openrobots-dev/R2P_GW_module/doc/SD-47589-001.pdf

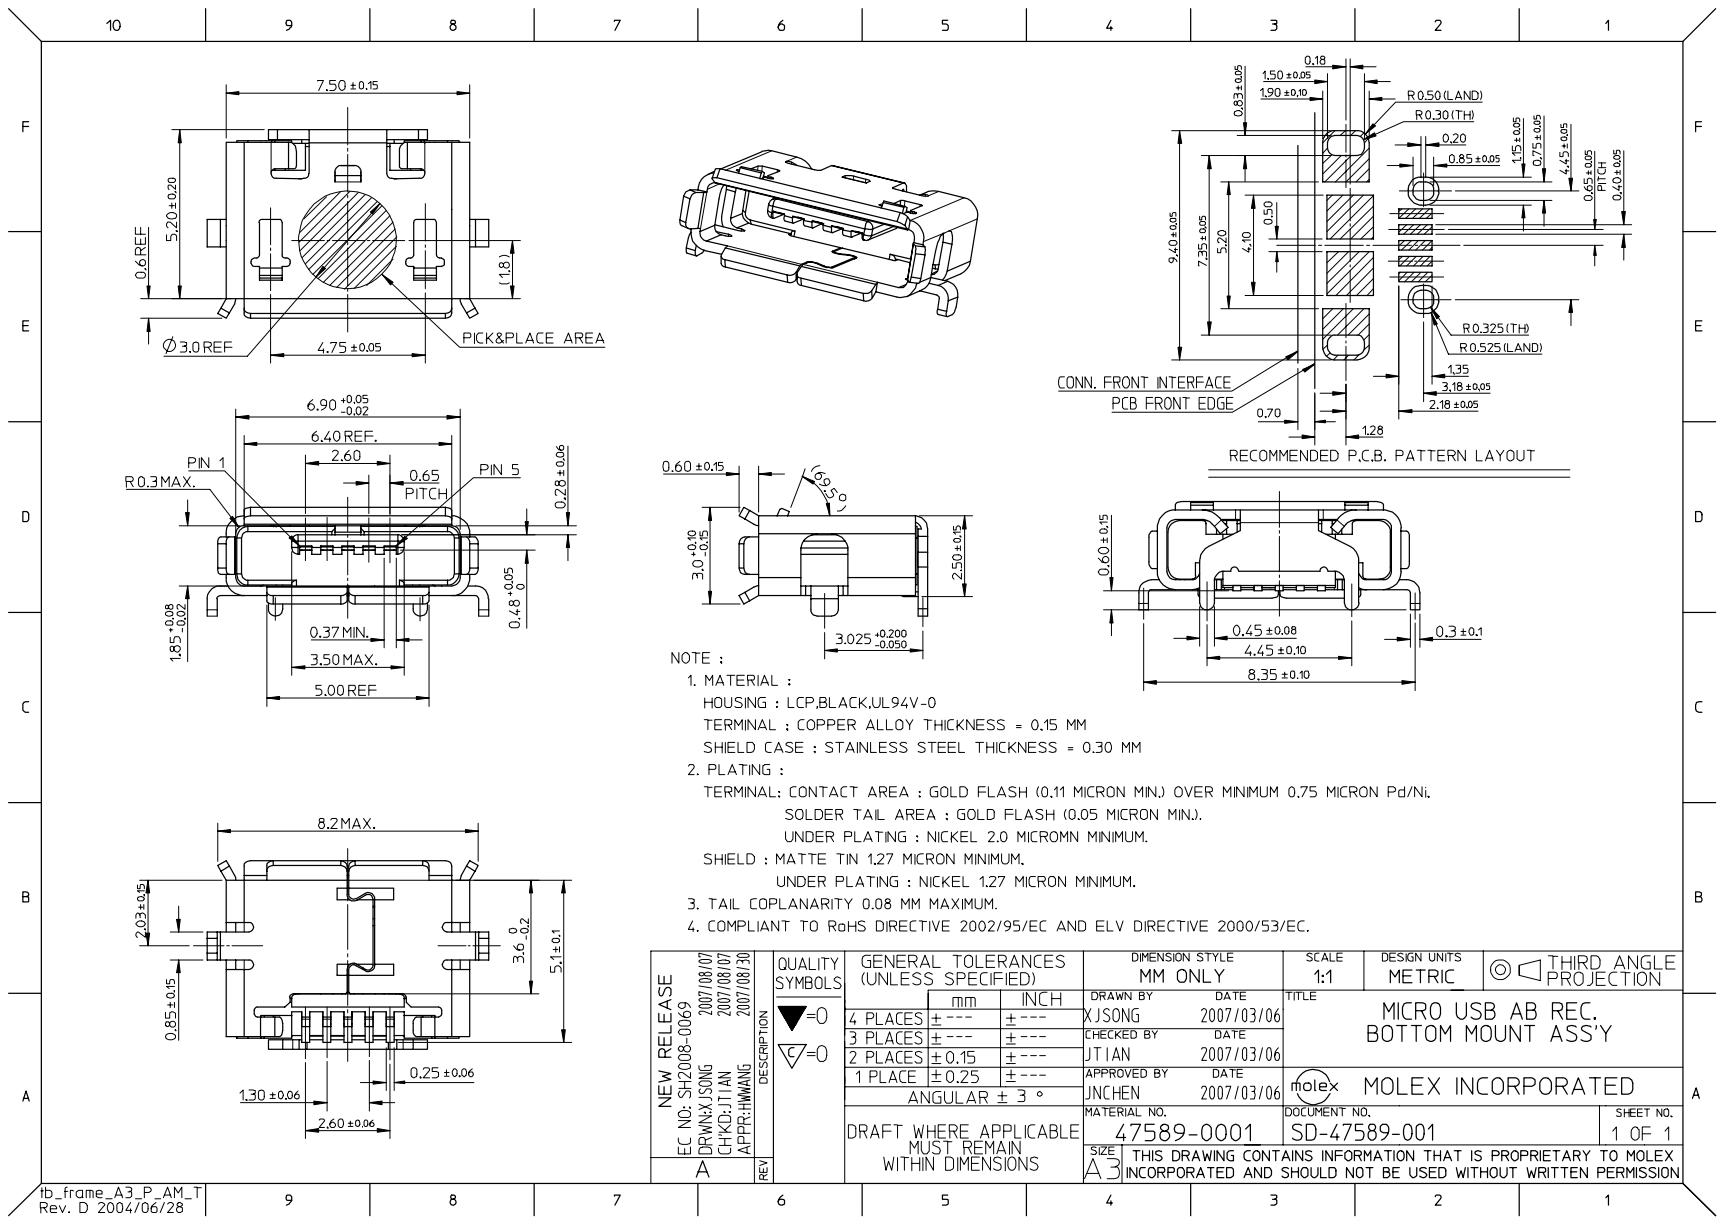
[picture p2: page 1]
