openrobots-dev/R2P_GW_module/doc/SI-60062-F.pdf

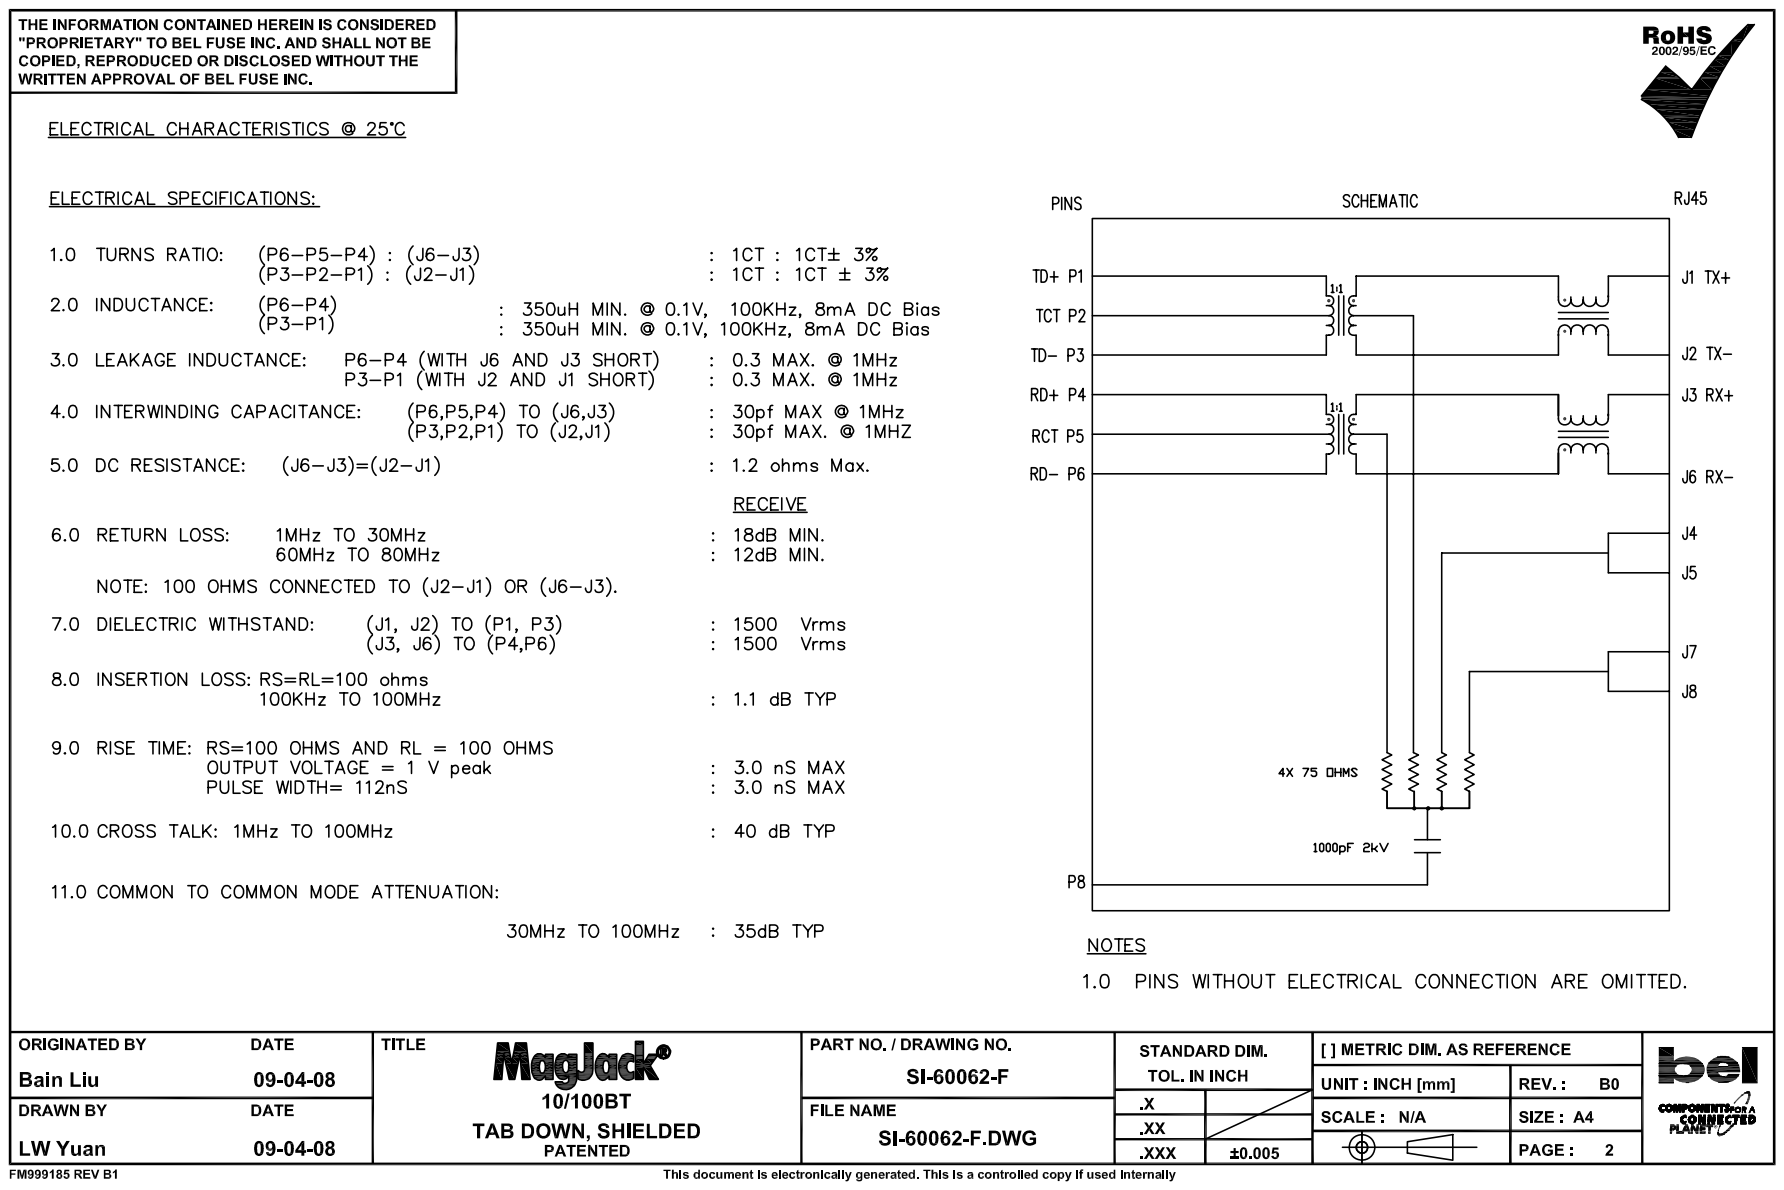
[picture p3: page 1]

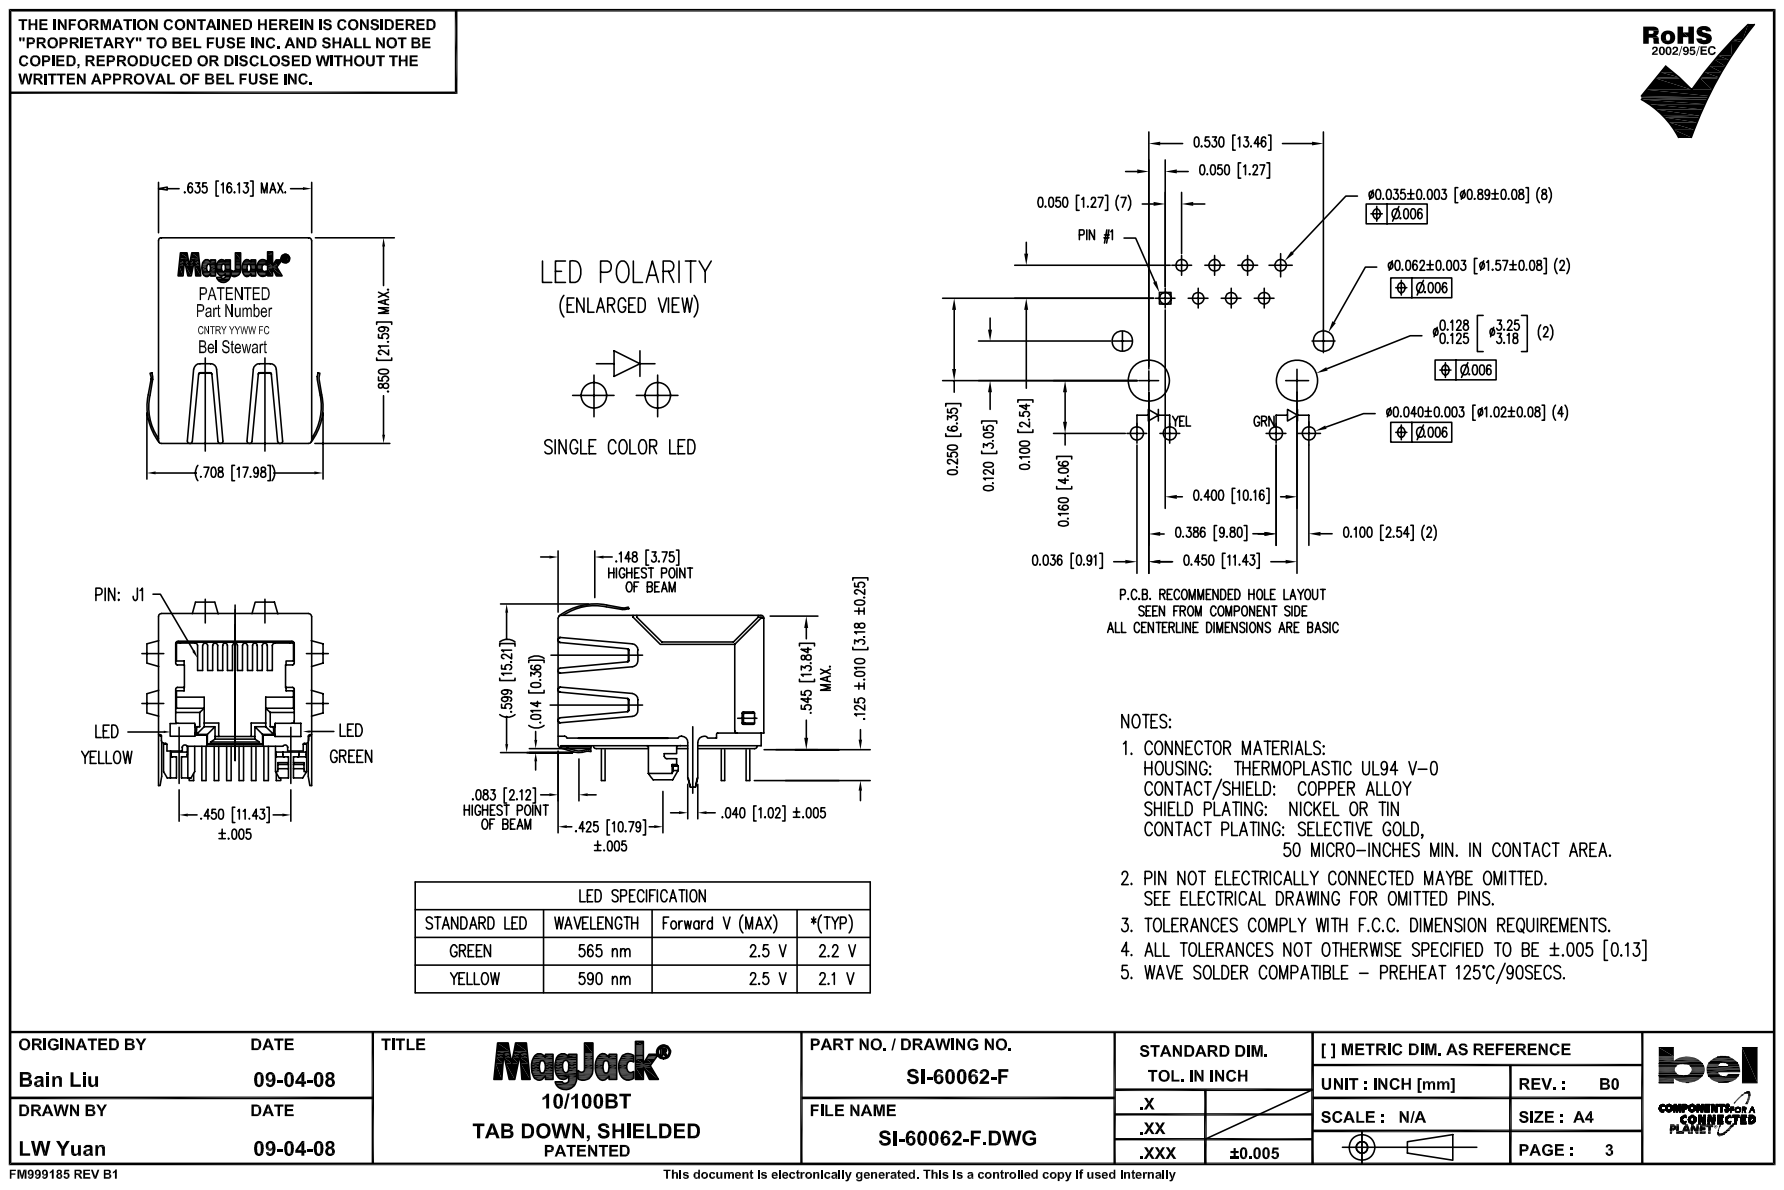
[picture p4: page 2]

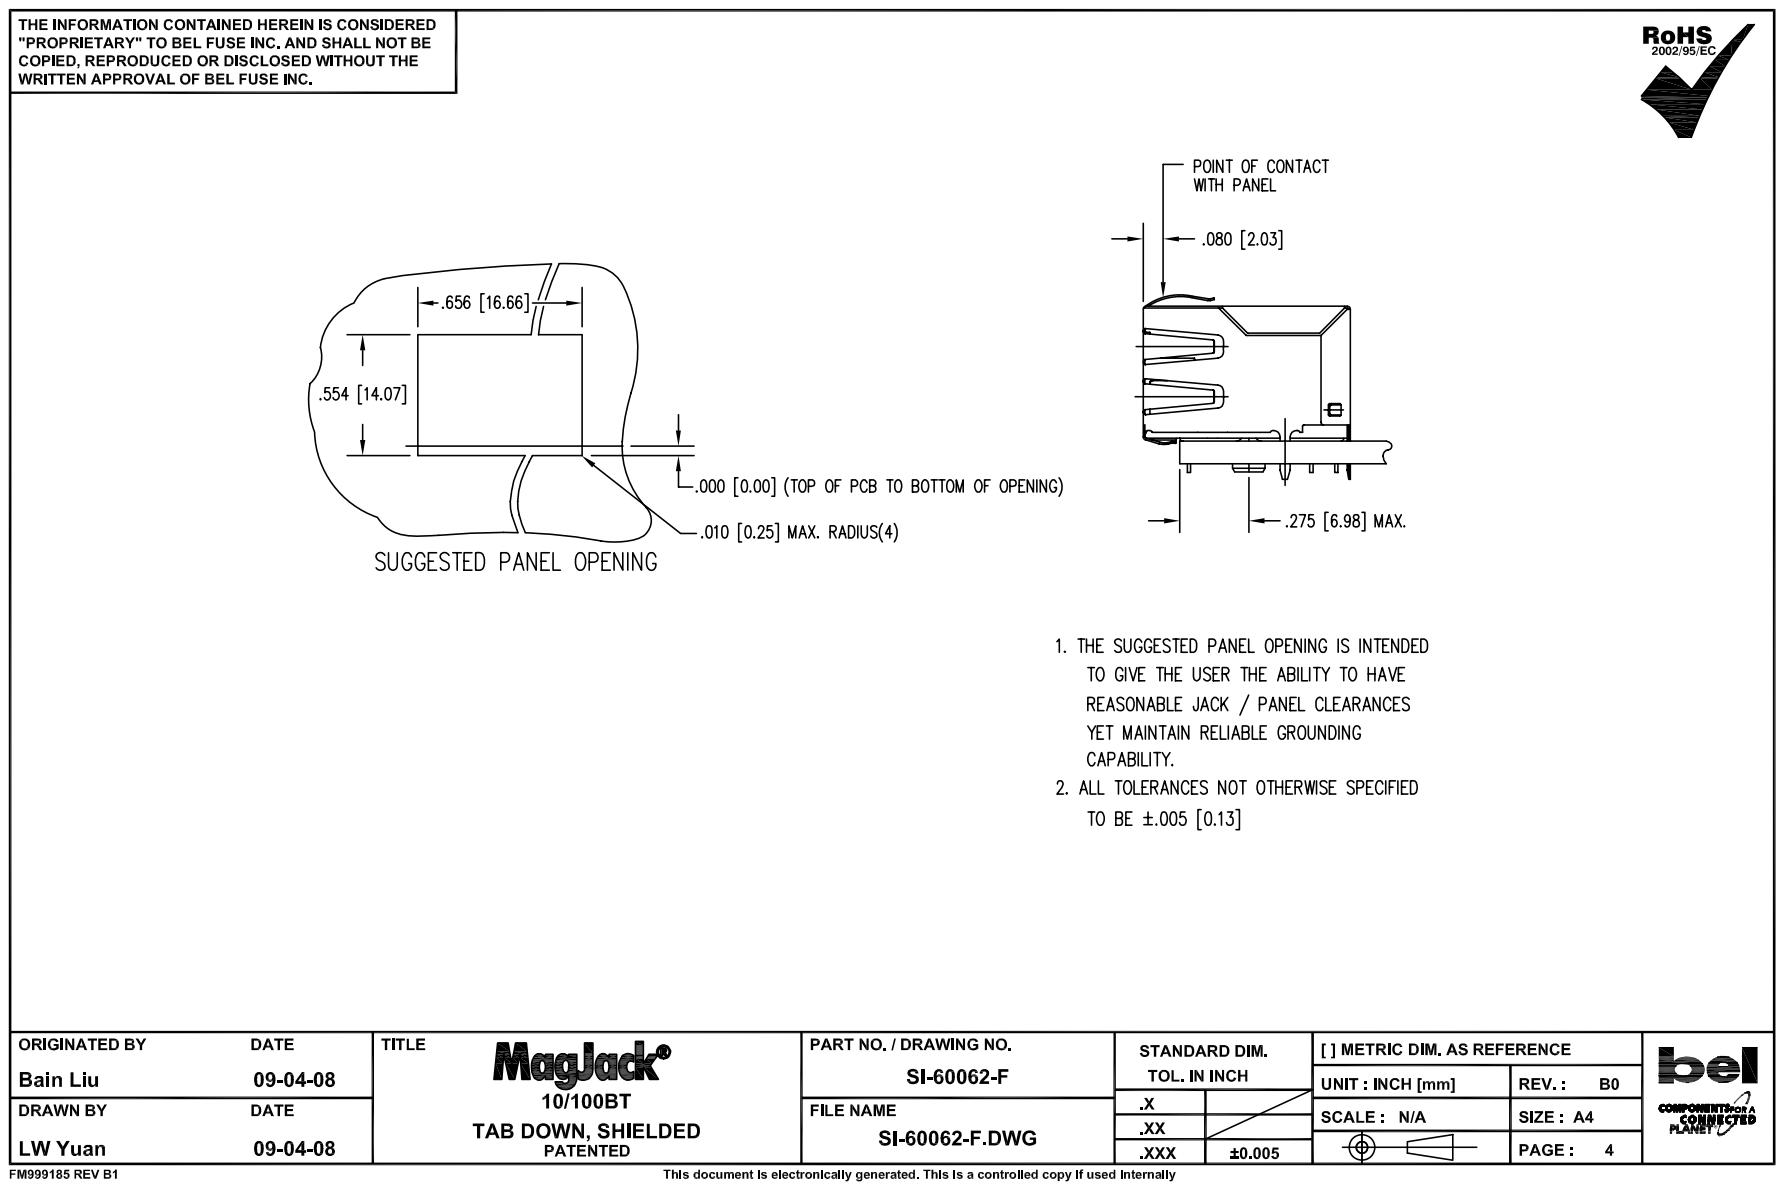
[picture p5: page 3]
