openrobots-dev/R2P_GW_module/hw/R2P_GW_module.brd

## EAGLE design hw/R2P_GW_module.brd (2013-06-18)

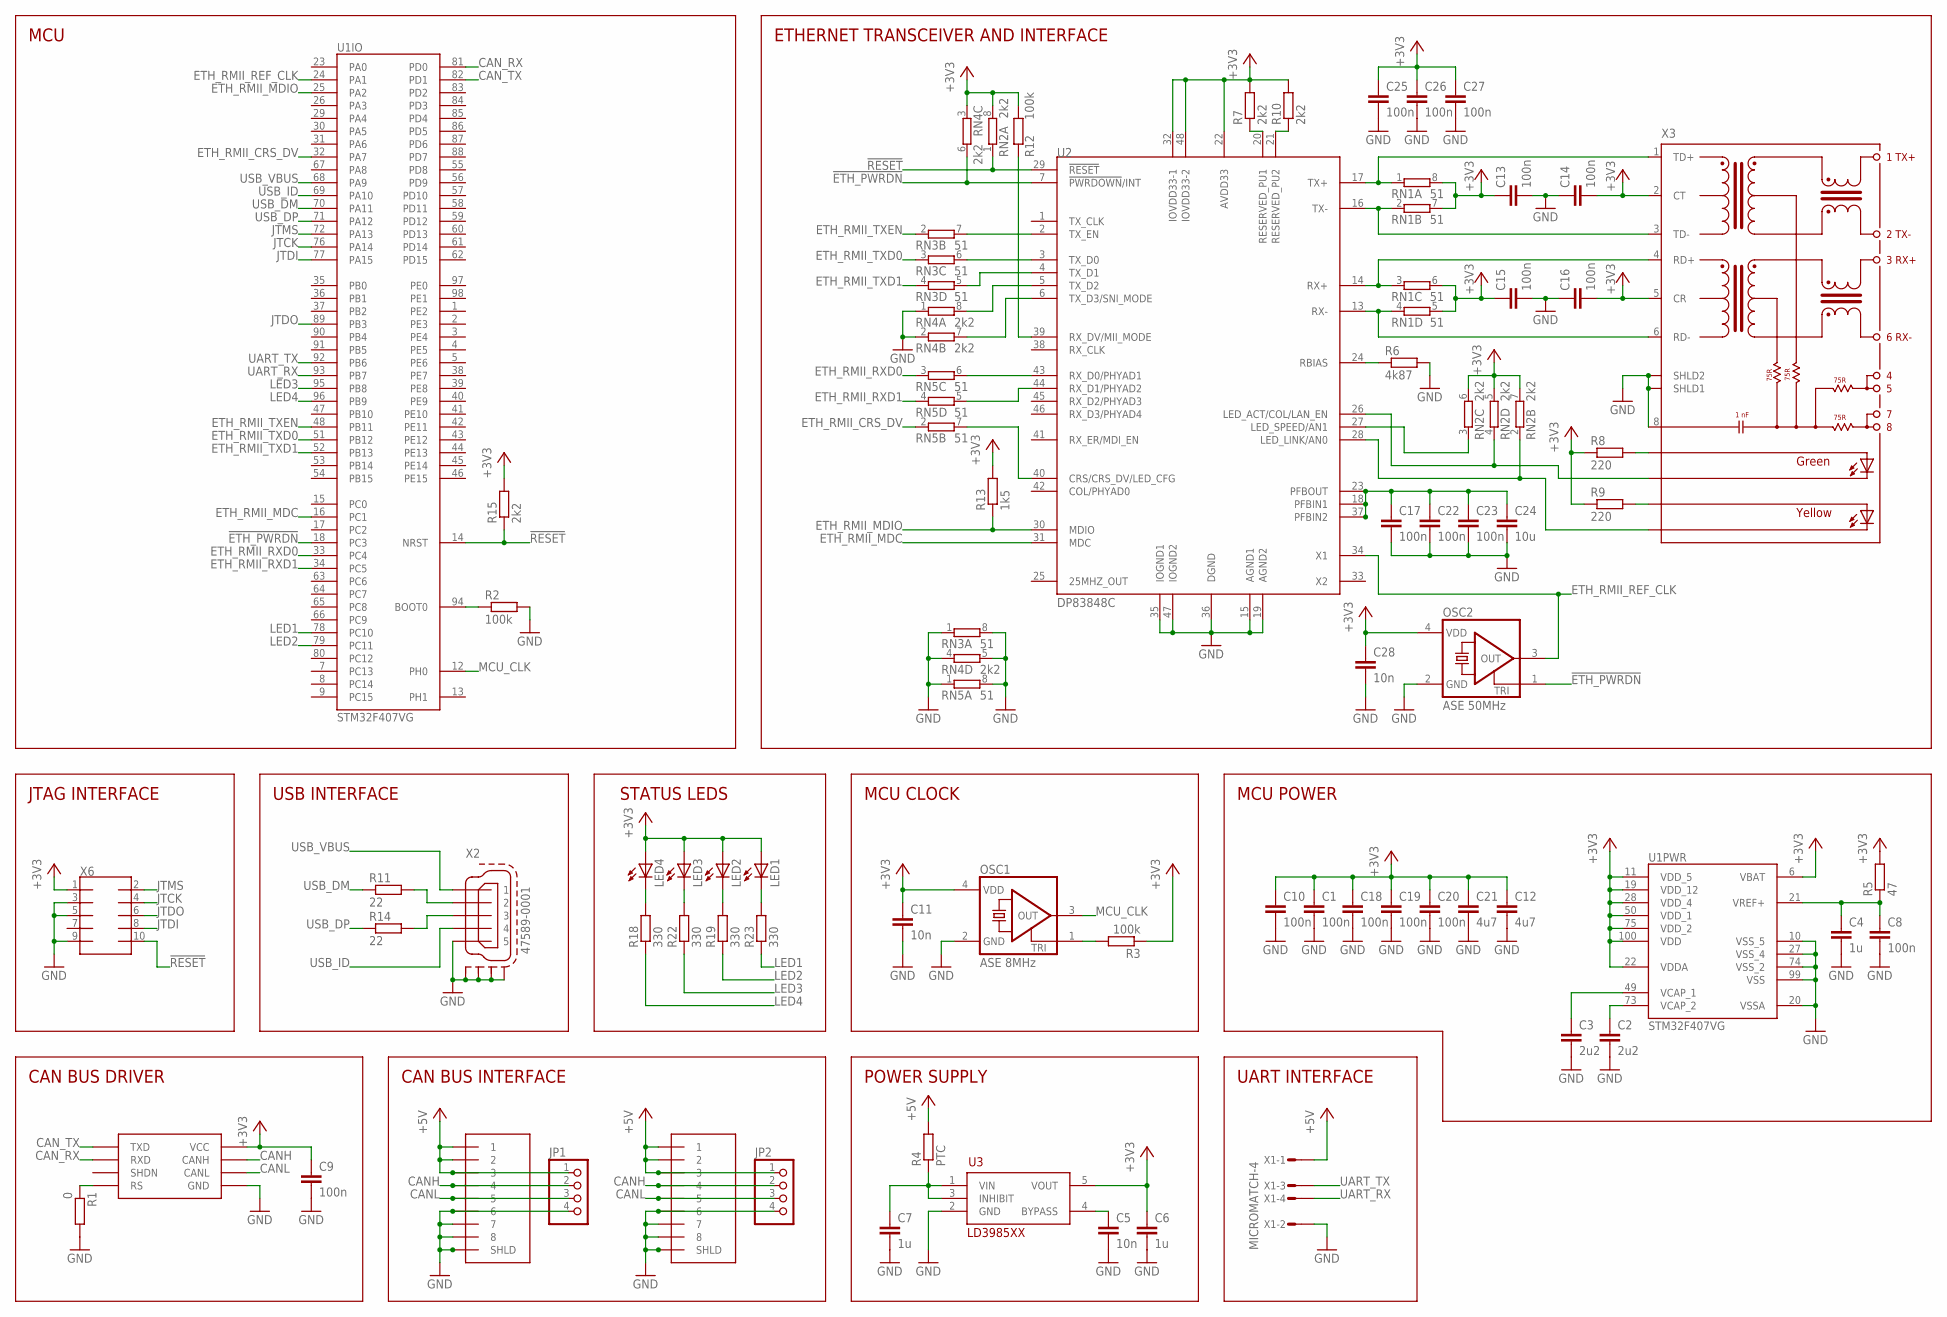
[picture p6: schematic R2P_GW_module.sch]

Parts:
C1, C8, C9, C10, C13, C14, C15, C16, C17, C18, C19, C20, C22, C23, C25, C26, C27: 100n; C0603
C2, C3: 2u2; C0805
C4, C6, C7: 1u; C0603
C5, C11, C28: 10n; C0603
C12, C21: 4u7; C0805
C24: 10u; C0805
JP1, JP2: PINHD-1X4; 1X04
LED1, LED2, LED3, LED4: LEDCHIPLED_0805; CHIPLED_0805
OSC1: ASE 8MHz; ASE
OSC2: ASE 50MHz; ASE
R1: 0; R0603
R2, R3, R12: 100k; R0603
R4: PTC; R0603
R5: 47; R0603
R6: 4k87; R0603
R7, R10, R15: 2k2; R0603
R8, R9: 220; R0603
R11, R14: 22; R0603
R13: 1k5; R0603
R18, R19, R22, R23: 330; R0603
RN1, RN3, RN5: 51; CAT16
RN2, RN4: 2k2; CAT16
U1: STM32F407VG; LQFP100
U2: DP83848C; LQFP48
U3: LD3985XX; SOT23-5L
U4: MAX3051; SOT23-8L
X1: MICROMATCH-4
X2: 47589-0001
X3: SI-60062-F
X4, X5: RJ45-43860; 0438600010
X6: FTSH-105

Connections:
!ETH_PWRDN: OSC2.1 (TRI), RN4.6 (2), U1.18 (PC3), U2.7 (!PWRDOWN!/INT)
!RESET: R15.1, RN2.1, U1.14 (NRST), U2.29 (!RESET), X6.10
+3V3: C1.1, C6.1, C9.1, C10.1, C11.1, C12.1, C13.1, C14.2, C15.1, C16.2, C18.1, C19.1, C20.1, C21.1, C25.1, C26.1, C27.1, C28.1, LED1.A, LED2.A, LED3.A, LED4.A, OSC1.4 (VDD), OSC2.4 (VDD), R3.1, R5.2, R7.2, R8.1, R9.1, R10.2, R12.2, R13.2, R15.2, RN1.5 (2), RN1.6 (2), RN1.7 (2), RN1.8 (2), RN2.5 (2), RN2.6 (2), RN2.7 (2), RN2.8 (2), RN4.3 (1), U1.6 (VBAT), U1.11 (VDD_5), U1.19 (VDD_12), U1.22 (VDDA), U1.28 (VDD_4), U1.50 (VDD_1), U1.75 (VDD_2), U1.100 (VDD), U2.22 (AVDD33), U2.32 (IOVDD33-1), U2.48 (IOVDD33-2), U3.5 (VOUT), U4.P$3 (VCC), X3.2 (CT), X3.5 (CR), X6.1
+5V: JP1.1, JP2.1, R4.2, X1.1, X4.P$1 (1), X4.P$2 (2), X4.P$3 (3), X5.P$1 (1), X5.P$2 (2), X5.P$3 (3)
CANH: JP1.2, JP2.2, U4.P$7 (CANH), X4.P$4 (4), X5.P$4 (4)
CANL: JP1.3, JP2.3, U4.P$6 (CANL), X4.P$5 (5), X5.P$5 (5)
CAN_RX: U1.81 (PD0), U4.P$4 (RXD)
CAN_TX: U1.82 (PD1), U4.P$1 (TXD)
ETH_RMII_CRS_DV: RN5.2 (1), U1.32 (PA7)
ETH_RMII_MDC: U1.16 (PC1), U2.31 (MDC)
ETH_RMII_MDIO: R13.1, U1.25 (PA2), U2.30 (MDIO)
ETH_RMII_REF_CLK: OSC2.3 (OUT), U1.24 (PA1), U2.34 (X1)
ETH_RMII_RXD0: RN5.3 (1), U1.33 (PC4)
ETH_RMII_RXD1: RN5.4 (1), U1.34 (PC5)
ETH_RMII_TXD0: RN3.3 (1), U1.51 (PB12)
ETH_RMII_TXD1: RN3.4 (1), U1.52 (PB13)
ETH_RMII_TXEN: RN3.2 (1), U1.48 (PB11)
GND: C1.2, C2.2, C3.2, C4.2, C5.2, C6.2, C7.2, C8.2, C9.2, C10.2, C11.2, C12.2, C13.2, C14.1, C15.2, C16.1, C17.2, C18.2, C19.2, C20.2, C21.2, C22.2, C23.2, C24.2, C25.2, C26.2, C27.2, C28.2, JP1.4, JP2.4, OSC1.2 (GND), OSC2.2 (GND), R1.2, R2.2, R6.2, RN3.1, RN3.8 (2), RN4.1, RN4.2 (1), RN4.4 (1), RN4.5 (2), RN5.1, RN5.8 (2), U1.10 (VSS_5), U1.20 (VSSA), U1.27 (VSS_4), U1.74 (VSS_2), U1.99 (VSS), U2.15 (AGND1), U2.19 (AGND2), U2.35 (IOGND1), U2.36 (DGND), U2.47 (IOGND2), U3.2 (GND), U4.P$2 (GND), X1.2, X2.5, X2.SHLD1, X2.SHLD2, X2.SHLD3, X2.SHLD4, X3.8, X3.SHLD1, X3.SHLD2, X4.P$6 (6), X4.P$7 (7), X4.P$8 (8), X4.P$9 (SHLD), X4.P$10, X5.P$6 (6), X5.P$7 (7), X5.P$8 (8), X5.P$9 (SHLD), X5.P$10, X6.3, X6.5, X6.9
JTCK: U1.76 (PA14), X6.4
JTDI: U1.77 (PA15), X6.8
JTDO: U1.89 (PB3), X6.6
JTMS: U1.72 (PA13), X6.2
LED1: R23.1, U1.78 (PC10)
LED2: R19.1, U1.79 (PC11)
LED3: R22.1, U1.95 (PB8)
LED4: R18.1, U1.96 (PB9)
MCU_CLK: OSC1.3 (OUT), U1.12 (PH0)
unnamed: C4.1, C8.1, R5.1, U1.21 (VREF+)
unnamed: R1.1, U4.P$8 (RS)
unnamed: OSC1.1 (TRI), R3.2
unnamed: C5.1, U3.4 (BYPASS)
unnamed: C7.1, R4.1, U3.1 (VIN), U3.3 (INHIBIT)
unnamed: R6.1, U2.24 (RBIAS)
unnamed: R11.2, X2.2
unnamed: RN1.1, U2.17 (TX+), X3.1 (TD+)
unnamed: RN1.2 (1), U2.16 (TX-), X3.3 (TD-)
unnamed: RN1.3 (1), U2.14 (RX+), X3.4 (RD+)
unnamed: RN1.4 (1), U2.13 (RX-), X3.6 (RD-)
unnamed: R9.2, X3.YA
unnamed: C17.1, C22.1, C23.1, C24.1, U2.18 (PFBIN1), U2.23 (PFBOUT), U2.37 (PFBIN2)
unnamed: LED4.C, R18.2
unnamed: R8.2, X3.GA
unnamed: LED2.C, R19.2
unnamed: RN2.3 (1), U2.27 (LED_SPEED/AN1)
unnamed: LED3.C, R22.2
unnamed: RN3.7 (2), U2.2 (TX_EN)
unnamed: LED1.C, R23.2
unnamed: RN2.2 (1), U2.28 (LED_LINK/AN0), X3.YK
unnamed: RN2.4 (1), U2.26 (LED_ACT/COL/LAN_EN), X3.GK
unnamed: RN3.6 (2), U2.3 (TX_D0)
unnamed: R2.1, U1.94 (BOOT0)
unnamed: R7.1, U2.20 (RESERVED_PU1)
unnamed: R10.1, U2.21 (RESERVED_PU2)
unnamed: RN3.5 (2), U2.4 (TX_D1)
unnamed: RN4.8 (2), U2.5 (TX_D2)
unnamed: RN4.7 (2), U2.6 (TX_D3/SNI_MODE)
unnamed: R14.2, X2.3
unnamed: RN5.6 (2), U2.43 (RX_D0/PHYAD1)
unnamed: R12.1, U2.39 (RX_DV/MII_MODE)
unnamed: RN5.5 (2), U2.44 (RX_D1/PHYAD2)
unnamed: RN5.7 (2), U2.40 (CRS/CRS_DV/LED_CFG)
UART_RX: U1.93 (PB7), X1.4
UART_TX: U1.92 (PB6), X1.3
USB_DM: R11.1, U1.70 (PA11)
USB_DP: R14.1, U1.71 (PA12)
USB_ID: U1.69 (PA10), X2.4
USB_VBUS: U1.68 (PA9), X2.1
VCAP_1: C3.1, U1.49 (VCAP_1)
VCAP_2: C2.1, U1.73 (VCAP_2)

Notes on the sheet:
MCU
POWER SUPPLY
STATUS LEDS
JTAG INTERFACE
CAN BUS INTERFACE
CAN BUS DRIVER
UART INTERFACE
ETHERNET TRANSCEIVER AND INTERFACE
MCU POWER
MCU CLOCK
USB INTERFACE

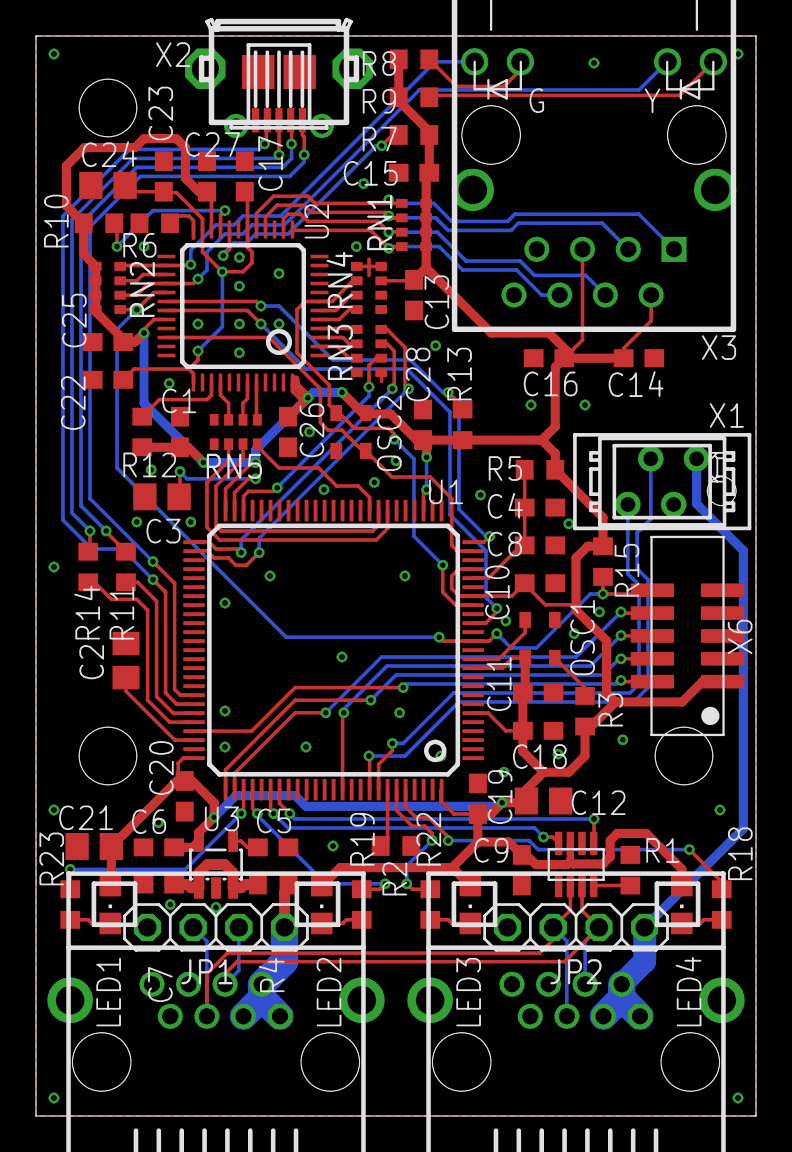
[picture p7: board R2P_GW_module.brd from above]

Board: 2 copper layers, 40.0 x 60.0 mm, 70 parts (0 on the bottom side), 69 nets.
