openrobots-dev/R2P_GW_module/board.h

/*
    ChibiOS/RT - Copyright (C) 2006,2007,2008,2009,2010,
                 2011,2012 Giovanni Di Sirio.

    This file is part of ChibiOS/RT.

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
    You should have received a copy of the GNU General Public License
    along with this program.  If not, see <http://www.gnu.org/licenses/>.
*/

#ifndef _BOARD_H_
#define _BOARD_H_

/*
 * Setup for R2P_GW board.
 */

/*
 * Board identifier.
 */
#define BOARD_R2P_GW
#define BOARD_NAME                  "R2P_GW"

/*
 * Ethernet PHY type.
 */
#define BOARD_PHY_ID                MII_DP83848I_ID
#define BOARD_PHY_RMII

/*
 * Board oscillators-related settings.
 */
#if !defined(STM32_LSECLK)
#define STM32_LSECLK                32768
#endif

#if !defined(STM32_HSECLK)
#define STM32_HSECLK                8000000
#endif


/*
 * Board voltages.
 * Required for performance limits calculation.
 */
#define STM32_VDD                   330

/*
 * MCU type as defined in the ST header file stm32f4xx.h.
 */
#define STM32F4XX

/*
 * IO pins assignments.
 */
#define GPIOA_PIN0                  0
#define GPIOA_ETH_RMII_REF_CLK      1
#define GPIOA_ETH_RMII_MDIO         2
#define GPIOA_PIN3                  3
#define GPIOA_PIN4                  4
#define GPIOA_PIN5                  5
#define GPIOA_PIN6                  6
#define GPIOA_ETH_RMII_CRS_DV       7
#define GPIOA_PIN8                  8
#define GPIOA_OTG_FS_VBUS           9
#define GPIOA_OTG_FS_ID             10
#define GPIOA_OTG_FS_DM             11
#define GPIOA_OTG_FS_DP             12
#define GPIOA_JTMS                  13
#define GPIOA_JTCK                  14
#define GPIOA_JTDI                  15

#define GPIOB_PIN0                  0
#define GPIOB_PIN1                  1
#define GPIOB_PIN2                  2
#define GPIOB_JTDO                  3
#define GPIOB_JTRST                 4
#define GPIOB_PIN5                  5
#define GPIOB_USART1_TX             6
#define GPIOB_USART1_RX             7
#define GPIOB_LED3                  8
#define GPIOB_LED4                  9
#define GPIOB_PIN10                 10
#define GPIOB_ETH_RMII_TX_EN        11
#define GPIOB_ETH_RMII_TXD0         12
#define GPIOB_ETH_RMII_TXD1         13
#define GPIOB_PIN14                 14
#define GPIOB_PIN15                 15

#define GPIOC_PIN0                  0
#define GPIOC_ETH_RMII_MDC          1
#define GPIOC_PIN2                  2
#define GPIOC_ETH_NOT_PWRDN         3
#define GPIOC_ETH_RMII_RXD0         4
#define GPIOC_ETH_RMII_RXD1         5
#define GPIOC_PIN6                  6
#define GPIOC_PIN7                  7
#define GPIOC_PIN8                  8
#define GPIOC_PIN9                  9
#define GPIOC_LED1                  10
#define GPIOC_LED2                  11
#define GPIOC_PIN12                 12
#define GPIOC_PIN13                 13
#define GPIOC_PIN14                 14
#define GPIOC_PIN15                 15

#define GPIOD_CAN1_RX               0
#define GPIOD_CAN1_TX               1
#define GPIOD_PIN2                  2
#define GPIOD_PIN3                  3
#define GPIOD_PIN4                  4
#define GPIOD_PIN5                  5
#define GPIOD_PIN6                  6
#define GPIOD_PIN7                  7
#define GPIOD_PIN8                  8
#define GPIOD_PIN9                  9
#define GPIOD_PIN10                 10
#define GPIOD_PIN11                 11
#define GPIOD_PIN12                 12
#define GPIOD_PIN13                 13
#define GPIOD_PIN14                 14
#define GPIOD_PIN15                 15

#define GPIOE_PIN0                  0
#define GPIOE_PIN1                  1
#define GPIOE_PIN2                  2
#define GPIOE_PIN3                  3
#define GPIOE_PIN4                  4
#define GPIOE_PIN5                  5
#define GPIOE_PIN6                  6
#define GPIOE_PIN7                  7
#define GPIOE_PIN8                  8
#define GPIOE_PIN9                  9
#define GPIOE_PIN10                 10
#define GPIOE_PIN11                 11
#define GPIOE_PIN12                 12
#define GPIOE_PIN13                 13
#define GPIOE_PIN14                 14
#define GPIOE_PIN15                 15

#define GPIOF_PIN0                  0
#define GPIOF_PIN1                  1
#define GPIOF_PIN2                  2
#define GPIOF_PIN3                  3
#define GPIOF_PIN4                  4
#define GPIOF_PIN5                  5
#define GPIOF_PIN6                  6
#define GPIOF_PIN7                  7
#define GPIOF_PIN8                  8
#define GPIOF_PIN9                  9
#define GPIOF_PIN10                 10
#define GPIOF_PIN11                 11
#define GPIOF_PIN12                 12
#define GPIOF_PIN13                 13
#define GPIOF_PIN14                 14
#define GPIOF_PIN15                 15

#define GPIOG_PIN0                  0
#define GPIOG_PIN1                  1
#define GPIOG_PIN2                  2
#define GPIOG_PIN3                  3
#define GPIOG_PIN4                  4
#define GPIOG_PIN5                  5
#define GPIOG_PIN6                  6
#define GPIOG_PIN7                  7
#define GPIOG_PIN8                  8
#define GPIOG_PIN9                  9
#define GPIOG_PIN10                 10
#define GPIOG_PIN11                 11
#define GPIOG_PIN12                 12
#define GPIOG_PIN13                 13
#define GPIOG_PIN14                 14
#define GPIOG_PIN15                 15

#define GPIOH_MCU_CLK               0
#define GPIOH_PIN1                  1
#define GPIOH_PIN2                  2
#define GPIOH_PIN3                  3
#define GPIOH_PIN4                  4
#define GPIOH_PIN5                  5
#define GPIOH_PIN6                  6
#define GPIOH_PIN7                  7
#define GPIOH_PIN8                  8
#define GPIOH_PIN9                  9
#define GPIOH_PIN10                 10
#define GPIOH_PIN11                 11
#define GPIOH_PIN12                 12
#define GPIOH_PIN13                 13
#define GPIOH_PIN14                 14
#define GPIOH_PIN15                 15

#define GPIOI_PIN0                  0
#define GPIOI_PIN1                  1
#define GPIOI_PIN2                  2
#define GPIOI_PIN3                  3
#define GPIOI_PIN4                  4
#define GPIOI_PIN5                  5
#define GPIOI_PIN6                  6
#define GPIOI_PIN7                  7
#define GPIOI_PIN8                  8
#define GPIOI_PIN9                  9
#define GPIOI_PIN10                 10
#define GPIOI_PIN11                 11
#define GPIOI_PIN12                 12
#define GPIOI_PIN13                 13
#define GPIOI_PIN14                 14
#define GPIOI_PIN15                 15

/*
 * I/O ports initial setup, this configuration is established soon after reset
 * in the initialization code.
 * Please refer to the STM32 Reference Manual for details.
 */
#define PIN_MODE_INPUT(n)           (0U << ((n) * 2))
#define PIN_MODE_OUTPUT(n)          (1U << ((n) * 2))
#define PIN_MODE_ALTERNATE(n)       (2U << ((n) * 2))
#define PIN_MODE_ANALOG(n)          (3U << ((n) * 2))
#define PIN_ODR_LOW(n)              (0U << (n))
#define PIN_ODR_HIGH(n)             (1U << (n))
#define PIN_OTYPE_PUSHPULL(n)       (0U << (n))
#define PIN_OTYPE_OPENDRAIN(n)      (1U << (n))
#define PIN_OSPEED_2M(n)            (0U << ((n) * 2))
#define PIN_OSPEED_25M(n)           (1U << ((n) * 2))
#define PIN_OSPEED_50M(n)           (2U << ((n) * 2))
#define PIN_OSPEED_100M(n)          (3U << ((n) * 2))
#define PIN_PUPDR_FLOATING(n)       (0U << ((n) * 2))
#define PIN_PUPDR_PULLUP(n)         (1U << ((n) * 2))
#define PIN_PUPDR_PULLDOWN(n)       (2U << ((n) * 2))
#define PIN_AFIO_AF(n, v)           ((v##U) << ((n % 8) * 4))

/*
 * GPIOA setup:
 *
 * PA0  - PIN0                      (input pullup).
 * PA1  - ETH_RMII_REF_CLK          (alternate 11).
 * PA2  - ETH_RMII_MDIO             (alternate 11).
 * PA3  - PIN3                      (input pullup).
 * PA4  - PIN4                      (input pullup).
 * PA5  - PIN5                      (input pullup).
 * PA6  - PIN6                      (input pullup).
 * PA7  - ETH_RMII_CRS_DV           (alternate 11).
 * PA8  - PIN8                      (input pullup).
 * PA9  - OTG_FS_VBUS               (input pulldown).
 * PA10 - OTG_FS_ID                 (alternate 10).
 * PA11 - OTG_FS_DM                 (alternate 10).
 * PA12 - OTG_FS_DP                 (alternate 10).
 * PA13 - JTMS                      (alternate 0).
 * PA14 - JTCK                      (alternate 0).
 * PA15 - JTDI                      (alternate 0).
 */
#define VAL_GPIOA_MODER             (PIN_MODE_INPUT(GPIOA_PIN0) |           \
                                     PIN_MODE_ALTERNATE(GPIOA_ETH_RMII_REF_CLK) |\
                                     PIN_MODE_ALTERNATE(GPIOA_ETH_RMII_MDIO) |\
                                     PIN_MODE_INPUT(GPIOA_PIN3) |           \
                                     PIN_MODE_INPUT(GPIOA_PIN4) |           \
                                     PIN_MODE_INPUT(GPIOA_PIN5) |           \
                                     PIN_MODE_INPUT(GPIOA_PIN6) |           \
                                     PIN_MODE_ALTERNATE(GPIOA_ETH_RMII_CRS_DV) |\
                                     PIN_MODE_ALTERNATE(GPIOA_PIN8) |           \
                                     PIN_MODE_INPUT(GPIOA_OTG_FS_VBUS) |    \
                                     PIN_MODE_ALTERNATE(GPIOA_OTG_FS_ID) |  \
                                     PIN_MODE_ALTERNATE(GPIOA_OTG_FS_DM) |  \
                                     PIN_MODE_ALTERNATE(GPIOA_OTG_FS_DP) |  \
                                     PIN_MODE_ALTERNATE(GPIOA_JTMS) |       \
                                     PIN_MODE_ALTERNATE(GPIOA_JTCK) |       \
                                     PIN_MODE_ALTERNATE(GPIOA_JTDI))
#define VAL_GPIOA_OTYPER            (PIN_OTYPE_PUSHPULL(GPIOA_PIN0) |       \
                                     PIN_OTYPE_PUSHPULL(GPIOA_ETH_RMII_REF_CLK) |\
                                     PIN_OTYPE_PUSHPULL(GPIOA_ETH_RMII_MDIO) |\
                                     PIN_OTYPE_PUSHPULL(GPIOA_PIN3) |       \
                                     PIN_OTYPE_PUSHPULL(GPIOA_PIN4) |       \
                                     PIN_OTYPE_PUSHPULL(GPIOA_PIN5) |       \
                                     PIN_OTYPE_PUSHPULL(GPIOA_PIN6) |       \
                                     PIN_OTYPE_PUSHPULL(GPIOA_ETH_RMII_CRS_DV) |\
                                     PIN_OTYPE_PUSHPULL(GPIOA_PIN8) |       \
                                     PIN_OTYPE_PUSHPULL(GPIOA_OTG_FS_VBUS) |\
                                     PIN_OTYPE_PUSHPULL(GPIOA_OTG_FS_ID) |  \
                                     PIN_OTYPE_PUSHPULL(GPIOA_OTG_FS_DM) |  \
                                     PIN_OTYPE_PUSHPULL(GPIOA_OTG_FS_DP) |  \
                                     PIN_OTYPE_PUSHPULL(GPIOA_JTMS) |       \
                                     PIN_OTYPE_PUSHPULL(GPIOA_JTCK) |       \
                                     PIN_OTYPE_PUSHPULL(GPIOA_JTDI))
#define VAL_GPIOA_OSPEEDR           (PIN_OSPEED_100M(GPIOA_PIN0) |          \
                                     PIN_OSPEED_100M(GPIOA_ETH_RMII_REF_CLK) |\
                                     PIN_OSPEED_100M(GPIOA_ETH_RMII_MDIO) | \
                                     PIN_OSPEED_100M(GPIOA_PIN3) |          \
                                     PIN_OSPEED_100M(GPIOA_PIN4) |          \
                                     PIN_OSPEED_100M(GPIOA_PIN5) |          \
                                     PIN_OSPEED_100M(GPIOA_PIN6) |          \
                                     PIN_OSPEED_100M(GPIOA_ETH_RMII_CRS_DV) |\
                                     PIN_OSPEED_100M(GPIOA_PIN8) |          \
                                     PIN_OSPEED_100M(GPIOA_OTG_FS_VBUS) |   \
                                     PIN_OSPEED_100M(GPIOA_OTG_FS_ID) |     \
                                     PIN_OSPEED_100M(GPIOA_OTG_FS_DM) |     \
                                     PIN_OSPEED_100M(GPIOA_OTG_FS_DP) |     \
                                     PIN_OSPEED_100M(GPIOA_JTMS) |          \
                                     PIN_OSPEED_100M(GPIOA_JTCK) |          \
                                     PIN_OSPEED_100M(GPIOA_JTDI))
#define VAL_GPIOA_PUPDR             (PIN_PUPDR_PULLUP(GPIOA_PIN0) |         \
                                     PIN_PUPDR_FLOATING(GPIOA_ETH_RMII_REF_CLK) |\
                                     PIN_PUPDR_FLOATING(GPIOA_ETH_RMII_MDIO) |\
                                     PIN_PUPDR_PULLUP(GPIOA_PIN3) |         \
                                     PIN_PUPDR_PULLUP(GPIOA_PIN4) |         \
                                     PIN_PUPDR_PULLUP(GPIOA_PIN5) |         \
                                     PIN_PUPDR_PULLUP(GPIOA_PIN6) |         \
                                     PIN_PUPDR_FLOATING(GPIOA_ETH_RMII_CRS_DV) |\
                                     PIN_PUPDR_PULLUP(GPIOA_PIN8) |         \
                                     PIN_PUPDR_PULLDOWN(GPIOA_OTG_FS_VBUS) |\
                                     PIN_PUPDR_FLOATING(GPIOA_OTG_FS_ID) |  \
                                     PIN_PUPDR_FLOATING(GPIOA_OTG_FS_DM) |  \
                                     PIN_PUPDR_FLOATING(GPIOA_OTG_FS_DP) |  \
                                     PIN_PUPDR_PULLUP(GPIOA_JTMS) |         \
                                     PIN_PUPDR_PULLDOWN(GPIOA_JTCK) |       \
                                     PIN_PUPDR_PULLUP(GPIOA_JTDI))
#define VAL_GPIOA_ODR               (PIN_ODR_HIGH(GPIOA_PIN0) |             \
                                     PIN_ODR_HIGH(GPIOA_ETH_RMII_REF_CLK) | \
                                     PIN_ODR_HIGH(GPIOA_ETH_RMII_MDIO) |    \
                                     PIN_ODR_HIGH(GPIOA_PIN3) |             \
                                     PIN_ODR_HIGH(GPIOA_PIN4) |             \
                                     PIN_ODR_HIGH(GPIOA_PIN5) |             \
                                     PIN_ODR_HIGH(GPIOA_PIN6) |             \
                                     PIN_ODR_HIGH(GPIOA_ETH_RMII_CRS_DV) |  \
                                     PIN_ODR_HIGH(GPIOA_PIN8) |             \
                                     PIN_ODR_HIGH(GPIOA_OTG_FS_VBUS) |      \
                                     PIN_ODR_HIGH(GPIOA_OTG_FS_ID) |        \
                                     PIN_ODR_HIGH(GPIOA_OTG_FS_DM) |        \
                                     PIN_ODR_HIGH(GPIOA_OTG_FS_DP) |        \
                                     PIN_ODR_HIGH(GPIOA_JTMS) |             \
                                     PIN_ODR_HIGH(GPIOA_JTCK) |             \
                                     PIN_ODR_HIGH(GPIOA_JTDI))
#define VAL_GPIOA_AFRL              (PIN_AFIO_AF(GPIOA_PIN0, 0) |           \
                                     PIN_AFIO_AF(GPIOA_ETH_RMII_REF_CLK, 11) |\
                                     PIN_AFIO_AF(GPIOA_ETH_RMII_MDIO, 11) | \
                                     PIN_AFIO_AF(GPIOA_PIN3, 0) |           \
                                     PIN_AFIO_AF(GPIOA_PIN4, 0) |           \
                                     PIN_AFIO_AF(GPIOA_PIN5, 0) |           \
                                     PIN_AFIO_AF(GPIOA_PIN6, 0) |           \
                                     PIN_AFIO_AF(GPIOA_ETH_RMII_CRS_DV, 11))
#define VAL_GPIOA_AFRH              (PIN_AFIO_AF(GPIOA_PIN8, 0) |           \
                                     PIN_AFIO_AF(GPIOA_OTG_FS_VBUS, 0) |    \
                                     PIN_AFIO_AF(GPIOA_OTG_FS_ID, 10) |     \
                                     PIN_AFIO_AF(GPIOA_OTG_FS_DM, 10) |     \
                                     PIN_AFIO_AF(GPIOA_OTG_FS_DP, 10) |     \
                                     PIN_AFIO_AF(GPIOA_JTMS, 0) |           \
                                     PIN_AFIO_AF(GPIOA_JTCK, 0) |           \
                                     PIN_AFIO_AF(GPIOA_JTDI, 0))

/*
 * GPIOB setup:
 *
 * PB0  - PIN0                      (input pullup).
 * PB1  - PIN1                      (input pullup).
 * PB2  - PIN2                      (input pullup).
 * PB3  - JTDO                      (alternate 0).
 * PB4  - JTRST                     (alternate 0).
 * PB5  - PIN5                      (input pullup).
 * PB6  - USART1_TX                 (alternate 7).
 * PB7  - USART1_RX                 (alternate 7).
 * PB8  - LED3                      (output pushpull maximum).
 * PB9  - LED4                      (output pushpull maximum).
 * PB10 - PIN10                     (input pullup).
 * PB11 - ETH_RMII_TX_EN            (alternate 11).
 * PB12 - ETH_RMII_TXD0             (alternate 11).
 * PB13 - ETH_RMII_TXD1             (alternate 11).
 * PB14 - PIN14                     (input pullup).
 * PB15 - PIN15                     (input pullup).
 */
#define VAL_GPIOB_MODER             (PIN_MODE_INPUT(GPIOB_PIN0) |           \
                                     PIN_MODE_INPUT(GPIOB_PIN1) |           \
                                     PIN_MODE_INPUT(GPIOB_PIN2) |           \
                                     PIN_MODE_ALTERNATE(GPIOB_JTDO) |       \
                                     PIN_MODE_ALTERNATE(GPIOB_JTRST) |      \
                                     PIN_MODE_INPUT(GPIOB_PIN5) |           \
                                     PIN_MODE_ALTERNATE(GPIOB_USART1_TX) |  \
                                     PIN_MODE_ALTERNATE(GPIOB_USART1_RX) |  \
                                     PIN_MODE_OUTPUT(GPIOB_LED3) |          \
                                     PIN_MODE_OUTPUT(GPIOB_LED4) |          \
                                     PIN_MODE_INPUT(GPIOB_PIN10) |          \
                                     PIN_MODE_ALTERNATE(GPIOB_ETH_RMII_TX_EN) |\
                                     PIN_MODE_ALTERNATE(GPIOB_ETH_RMII_TXD0) |\
                                     PIN_MODE_ALTERNATE(GPIOB_ETH_RMII_TXD1) |\
                                     PIN_MODE_INPUT(GPIOB_PIN14) |          \
                                     PIN_MODE_INPUT(GPIOB_PIN15))
#define VAL_GPIOB_OTYPER            (PIN_OTYPE_PUSHPULL(GPIOB_PIN0) |       \
                                     PIN_OTYPE_PUSHPULL(GPIOB_PIN1) |       \
                                     PIN_OTYPE_PUSHPULL(GPIOB_PIN2) |       \
                                     PIN_OTYPE_PUSHPULL(GPIOB_JTDO) |       \
                                     PIN_OTYPE_PUSHPULL(GPIOB_JTRST) |      \
                                     PIN_OTYPE_PUSHPULL(GPIOB_PIN5) |       \
                                     PIN_OTYPE_PUSHPULL(GPIOB_USART1_TX) |  \
                                     PIN_OTYPE_PUSHPULL(GPIOB_USART1_RX) |  \
                                     PIN_OTYPE_PUSHPULL(GPIOB_LED3) |       \
                                     PIN_OTYPE_PUSHPULL(GPIOB_LED4) |       \
                                     PIN_OTYPE_PUSHPULL(GPIOB_PIN10) |      \
                                     PIN_OTYPE_PUSHPULL(GPIOB_ETH_RMII_TX_EN) |\
                                     PIN_OTYPE_PUSHPULL(GPIOB_ETH_RMII_TXD0) |\
                                     PIN_OTYPE_PUSHPULL(GPIOB_ETH_RMII_TXD1) |\
                                     PIN_OTYPE_PUSHPULL(GPIOB_PIN14) |      \
                                     PIN_OTYPE_PUSHPULL(GPIOB_PIN15))
#define VAL_GPIOB_OSPEEDR           (PIN_OSPEED_100M(GPIOB_PIN0) |          \
                                     PIN_OSPEED_100M(GPIOB_PIN1) |          \
                                     PIN_OSPEED_100M(GPIOB_PIN2) |          \
                                     PIN_OSPEED_100M(GPIOB_JTDO) |          \
                                     PIN_OSPEED_100M(GPIOB_JTRST) |         \
                                     PIN_OSPEED_100M(GPIOB_PIN5) |          \
                                     PIN_OSPEED_100M(GPIOB_USART1_TX) |     \
                                     PIN_OSPEED_100M(GPIOB_USART1_RX) |     \
                                     PIN_OSPEED_100M(GPIOB_LED3) |          \
                                     PIN_OSPEED_100M(GPIOB_LED4) |          \
                                     PIN_OSPEED_100M(GPIOB_PIN10) |         \
                                     PIN_OSPEED_100M(GPIOB_ETH_RMII_TX_EN) |\
                                     PIN_OSPEED_100M(GPIOB_ETH_RMII_TXD0) | \
                                     PIN_OSPEED_100M(GPIOB_ETH_RMII_TXD1) | \
                                     PIN_OSPEED_100M(GPIOB_PIN14) |         \
                                     PIN_OSPEED_100M(GPIOB_PIN15))
#define VAL_GPIOB_PUPDR             (PIN_PUPDR_PULLUP(GPIOB_PIN0) |         \
                                     PIN_PUPDR_PULLUP(GPIOB_PIN1) |         \
                                     PIN_PUPDR_PULLUP(GPIOB_PIN2) |         \
                                     PIN_PUPDR_FLOATING(GPIOB_JTDO) |       \
                                     PIN_PUPDR_PULLUP(GPIOB_JTRST) |      \
                                     PIN_PUPDR_PULLUP(GPIOB_PIN5) |         \
                                     PIN_PUPDR_FLOATING(GPIOB_USART1_TX) |  \
                                     PIN_PUPDR_PULLUP(GPIOB_USART1_RX) |    \
                                     PIN_PUPDR_FLOATING(GPIOB_LED3) |       \
                                     PIN_PUPDR_FLOATING(GPIOB_LED4) |       \
                                     PIN_PUPDR_PULLUP(GPIOB_PIN10) |        \
                                     PIN_PUPDR_FLOATING(GPIOB_ETH_RMII_TX_EN) |\
                                     PIN_PUPDR_FLOATING(GPIOB_ETH_RMII_TXD0) |\
                                     PIN_PUPDR_FLOATING(GPIOB_ETH_RMII_TXD1) |\
                                     PIN_PUPDR_PULLUP(GPIOB_PIN14) |        \
                                     PIN_PUPDR_PULLUP(GPIOB_PIN15))
#define VAL_GPIOB_ODR               (PIN_ODR_HIGH(GPIOB_PIN0) |             \
                                     PIN_ODR_HIGH(GPIOB_PIN1) |             \
                                     PIN_ODR_HIGH(GPIOB_PIN2) |             \
                                     PIN_ODR_HIGH(GPIOB_JTDO) |             \
                                     PIN_ODR_HIGH(GPIOB_JTRST) |            \
                                     PIN_ODR_HIGH(GPIOB_PIN5) |             \
                                     PIN_ODR_HIGH(GPIOB_USART1_TX) |        \
                                     PIN_ODR_HIGH(GPIOB_USART1_RX) |        \
                                     PIN_ODR_HIGH(GPIOB_LED3) |             \
                                     PIN_ODR_HIGH(GPIOB_LED4) |             \
                                     PIN_ODR_HIGH(GPIOB_PIN10) |            \
                                     PIN_ODR_HIGH(GPIOB_ETH_RMII_TX_EN) |   \
                                     PIN_ODR_HIGH(GPIOB_ETH_RMII_TXD0) |    \
                                     PIN_ODR_HIGH(GPIOB_ETH_RMII_TXD1) |    \
                                     PIN_ODR_HIGH(GPIOB_PIN14) |            \
                                     PIN_ODR_HIGH(GPIOB_PIN15))
#define VAL_GPIOB_AFRL              (PIN_AFIO_AF(GPIOB_PIN0, 0) |           \
                                     PIN_AFIO_AF(GPIOB_PIN1, 0) |           \
                                     PIN_AFIO_AF(GPIOB_PIN2, 0) |           \
                                     PIN_AFIO_AF(GPIOB_JTDO, 0) |           \
                                     PIN_AFIO_AF(GPIOB_JTRST, 0) |          \
                                     PIN_AFIO_AF(GPIOB_PIN5, 0) |           \
                                     PIN_AFIO_AF(GPIOB_USART1_TX, 7) |      \
                                     PIN_AFIO_AF(GPIOB_USART1_RX, 7))
#define VAL_GPIOB_AFRH              (PIN_AFIO_AF(GPIOB_LED3, 0) |           \
                                     PIN_AFIO_AF(GPIOB_LED4, 0) |           \
                                     PIN_AFIO_AF(GPIOB_PIN10, 0) |          \
                                     PIN_AFIO_AF(GPIOB_ETH_RMII_TX_EN, 11) |\
                                     PIN_AFIO_AF(GPIOB_ETH_RMII_TXD0, 11) | \
                                     PIN_AFIO_AF(GPIOB_ETH_RMII_TXD1, 11) | \
                                     PIN_AFIO_AF(GPIOB_PIN14, 0) |          \
                                     PIN_AFIO_AF(GPIOB_PIN15, 0))

/*
 * GPIOC setup:
 *
 * PC0  - PIN0                      (input pullup).
 * PC1  - ETH_RMII_MDC              (alternate 11).
 * PC2  - PIN2                      (input pullup).
 * PC3  - ETH_NOT_PWRDN             (output pushpull maximum).
 * PC4  - ETH_RMII_RXD0             (alternate 11).
 * PC5  - ETH_RMII_RXD1             (alternate 11).
 * PC6  - PIN6                      (input pullup).
 * PC7  - PIN7                      (input pullup).
 * PC8  - PIN8                      (input pullup).
 * PC9  - PIN9                      (input pullup).
 * PC10 - LED1                      (output pushpull maximum).
 * PC11 - LED2                      (output pushpull maximum).
 * PC12 - PIN12                     (input pullup).
 * PC13 - PIN13                     (input pullup).
 * PC14 - PIN14                     (input pullup).
 * PC15 - PIN15                     (input pullup).
 */
#define VAL_GPIOC_MODER             (PIN_MODE_INPUT(GPIOC_PIN0) |           \
                                     PIN_MODE_ALTERNATE(GPIOC_ETH_RMII_MDC) |\
                                     PIN_MODE_INPUT(GPIOC_PIN2) |           \
                                     PIN_MODE_OUTPUT(GPIOC_ETH_NOT_PWRDN) | \
                                     PIN_MODE_ALTERNATE(GPIOC_ETH_RMII_RXD0) |\
                                     PIN_MODE_ALTERNATE(GPIOC_ETH_RMII_RXD1) |\
                                     PIN_MODE_INPUT(GPIOC_PIN6) |           \
                                     PIN_MODE_INPUT(GPIOC_PIN7) |           \
                                     PIN_MODE_INPUT(GPIOC_PIN8) |           \
                                     PIN_MODE_INPUT(GPIOC_PIN9) |           \
                                     PIN_MODE_OUTPUT(GPIOC_LED1) |          \
                                     PIN_MODE_OUTPUT(GPIOC_LED2) |          \
                                     PIN_MODE_INPUT(GPIOC_PIN12) |          \
                                     PIN_MODE_INPUT(GPIOC_PIN13) |          \
                                     PIN_MODE_INPUT(GPIOC_PIN14) |          \
                                     PIN_MODE_INPUT(GPIOC_PIN15))
#define VAL_GPIOC_OTYPER            (PIN_OTYPE_PUSHPULL(GPIOC_PIN0) |       \
                                     PIN_OTYPE_PUSHPULL(GPIOC_ETH_RMII_MDC) |\
                                     PIN_OTYPE_PUSHPULL(GPIOC_PIN2) |       \
                                     PIN_OTYPE_PUSHPULL(GPIOC_ETH_NOT_PWRDN) |\
                                     PIN_OTYPE_PUSHPULL(GPIOC_ETH_RMII_RXD0) |\
                                     PIN_OTYPE_PUSHPULL(GPIOC_ETH_RMII_RXD1) |\
                                     PIN_OTYPE_PUSHPULL(GPIOC_PIN6) |       \
                                     PIN_OTYPE_PUSHPULL(GPIOC_PIN7) |       \
                                     PIN_OTYPE_PUSHPULL(GPIOC_PIN8) |       \
                                     PIN_OTYPE_PUSHPULL(GPIOC_PIN9) |       \
                                     PIN_OTYPE_PUSHPULL(GPIOC_LED1) |       \
                                     PIN_OTYPE_PUSHPULL(GPIOC_LED2) |       \
                                     PIN_OTYPE_PUSHPULL(GPIOC_PIN12) |      \
                                     PIN_OTYPE_PUSHPULL(GPIOC_PIN13) |      \
                                     PIN_OTYPE_PUSHPULL(GPIOC_PIN14) |      \
                                     PIN_OTYPE_PUSHPULL(GPIOC_PIN15))
#define VAL_GPIOC_OSPEEDR           (PIN_OSPEED_100M(GPIOC_PIN0) |          \
                                     PIN_OSPEED_100M(GPIOC_ETH_RMII_MDC) |  \
                                     PIN_OSPEED_100M(GPIOC_PIN2) |          \
                                     PIN_OSPEED_100M(GPIOC_ETH_NOT_PWRDN) | \
                                     PIN_OSPEED_100M(GPIOC_ETH_RMII_RXD0) | \
                                     PIN_OSPEED_100M(GPIOC_ETH_RMII_RXD1) | \
                                     PIN_OSPEED_100M(GPIOC_PIN6) |          \
                                     PIN_OSPEED_100M(GPIOC_PIN7) |          \
                                     PIN_OSPEED_100M(GPIOC_PIN8) |          \
                                     PIN_OSPEED_100M(GPIOC_PIN9) |          \
                                     PIN_OSPEED_100M(GPIOC_LED1) |          \
                                     PIN_OSPEED_100M(GPIOC_LED2) |          \
                                     PIN_OSPEED_100M(GPIOC_PIN12) |         \
                                     PIN_OSPEED_100M(GPIOC_PIN13) |         \
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
                                     PIN_AFIO_AF(GPIOC_PIN13, 0) |          \
                                     PIN_AFIO_AF(GPIOC_PIN14, 0) |          \
                                     PIN_AFIO_AF(GPIOC_PIN15, 0))

/*
 * GPIOD setup:
 *
 * PD0  - CAN1_RX                   (alternate 9).
 * PD1  - CAN1_TX                   (alternate 9).
 * PD2  - PIN2                      (input pullup).
 * PD3  - PIN3                      (input pullup).
 * PD4  - PIN4                      (input pullup).
 * PD5  - PIN5                      (input pullup).
 * PD6  - PIN6                      (input pullup).
 * PD7  - PIN7                      (input pullup).
 * PD8  - PIN8                      (input pullup).
 * PD9  - PIN9                      (input pullup).
 * PD10 - PIN10                     (input pullup).
 * PD11 - PIN11                     (input pullup).
 * PD12 - PIN12                     (input pullup).
 * PD13 - PIN13                     (input pullup).
 * PD14 - PIN14                     (input pullup).
 * PD15 - PIN15                     (input pullup).
 */
#define VAL_GPIOD_MODER             (PIN_MODE_ALTERNATE(GPIOD_CAN1_RX) |    \
                                     PIN_MODE_ALTERNATE(GPIOD_CAN1_TX) |    \
                                     PIN_MODE_INPUT(GPIOD_PIN2) |           \
                                     PIN_MODE_INPUT(GPIOD_PIN3) |           \
                                     PIN_MODE_INPUT(GPIOD_PIN4) |           \
                                     PIN_MODE_INPUT(GPIOD_PIN5) |           \
                                     PIN_MODE_INPUT(GPIOD_PIN6) |           \
                                     PIN_MODE_INPUT(GPIOD_PIN7) |           \
                                     PIN_MODE_INPUT(GPIOD_PIN8) |           \
                                     PIN_MODE_INPUT(GPIOD_PIN9) |           \
                                     PIN_MODE_INPUT(GPIOD_PIN10) |          \
                                     PIN_MODE_INPUT(GPIOD_PIN11) |          \
                                     PIN_MODE_INPUT(GPIOD_PIN12) |          \
                                     PIN_MODE_INPUT(GPIOD_PIN13) |          \
                                     PIN_MODE_INPUT(GPIOD_PIN14) |          \
                                     PIN_MODE_INPUT(GPIOD_PIN15))
#define VAL_GPIOD_OTYPER            (PIN_OTYPE_PUSHPULL(GPIOD_CAN1_RX) |    \
                                     PIN_OTYPE_PUSHPULL(GPIOD_CAN1_TX) |    \
                                     PIN_OTYPE_PUSHPULL(GPIOD_PIN2) |       \
                                     PIN_OTYPE_PUSHPULL(GPIOD_PIN3) |       \
                                     PIN_OTYPE_PUSHPULL(GPIOD_PIN4) |       \
                                     PIN_OTYPE_PUSHPULL(GPIOD_PIN5) |       \
                                     PIN_OTYPE_PUSHPULL(GPIOD_PIN6) |       \
                                     PIN_OTYPE_PUSHPULL(GPIOD_PIN7) |       \
                                     PIN_OTYPE_PUSHPULL(GPIOD_PIN8) |       \
                                     PIN_OTYPE_PUSHPULL(GPIOD_PIN9) |       \
                                     PIN_OTYPE_PUSHPULL(GPIOD_PIN10) |      \
                                     PIN_OTYPE_PUSHPULL(GPIOD_PIN11) |      \
                                     PIN_OTYPE_PUSHPULL(GPIOD_PIN12) |      \
                                     PIN_OTYPE_PUSHPULL(GPIOD_PIN13) |      \
                                     PIN_OTYPE_PUSHPULL(GPIOD_PIN14) |      \
                                     PIN_OTYPE_PUSHPULL(GPIOD_PIN15))
#define VAL_GPIOD_OSPEEDR           (PIN_OSPEED_100M(GPIOD_CAN1_RX) |       \
                                     PIN_OSPEED_100M(GPIOD_CAN1_TX) |       \
                                     PIN_OSPEED_100M(GPIOD_PIN2) |          \
                                     PIN_OSPEED_100M(GPIOD_PIN3) |          \
                                     PIN_OSPEED_100M(GPIOD_PIN4) |          \
                                     PIN_OSPEED_100M(GPIOD_PIN5) |          \
                                     PIN_OSPEED_100M(GPIOD_PIN6) |          \
                                     PIN_OSPEED_100M(GPIOD_PIN7) |          \
                                     PIN_OSPEED_100M(GPIOD_PIN8) |          \
                                     PIN_OSPEED_100M(GPIOD_PIN9) |          \
                                     PIN_OSPEED_100M(GPIOD_PIN10) |         \
                                     PIN_OSPEED_100M(GPIOD_PIN11) |         \
                                     PIN_OSPEED_100M(GPIOD_PIN12) |         \
                                     PIN_OSPEED_100M(GPIOD_PIN13) |         \
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
                                     PIN_PUPDR_PULLUP(GPIOI_PIN14) |        \
                                     PIN_PUPDR_PULLUP(GPIOI_PIN15))
#define VAL_GPIOI_ODR               (PIN_ODR_HIGH(GPIOI_PIN0) |             \
                                     PIN_ODR_HIGH(GPIOI_PIN1) |             \
                                     PIN_ODR_HIGH(GPIOI_PIN2) |             \
                                     PIN_ODR_HIGH(GPIOI_PIN3) |             \
                                     PIN_ODR_HIGH(GPIOI_PIN4) |             \
                                     PIN_ODR_HIGH(GPIOI_PIN5) |             \
                                     PIN_ODR_HIGH(GPIOI_PIN6) |             \
                                     PIN_ODR_HIGH(GPIOI_PIN7) |             \
                                     PIN_ODR_HIGH(GPIOI_PIN8) |             \
                                     PIN_ODR_HIGH(GPIOI_PIN9) |             \
                                     PIN_ODR_HIGH(GPIOI_PIN10) |            \
                                     PIN_ODR_HIGH(GPIOI_PIN11) |            \
                                     PIN_ODR_HIGH(GPIOI_PIN12) |            \
                                     PIN_ODR_HIGH(GPIOI_PIN13) |            \
                                     PIN_ODR_HIGH(GPIOI_PIN14) |            \
                                     PIN_ODR_HIGH(GPIOI_PIN15))
#define VAL_GPIOI_AFRL              (PIN_AFIO_AF(GPIOI_PIN0, 0) |           \
                                     PIN_AFIO_AF(GPIOI_PIN1, 0) |           \
                                     PIN_AFIO_AF(GPIOI_PIN2, 0) |           \
                                     PIN_AFIO_AF(GPIOI_PIN3, 0) |           \
                                     PIN_AFIO_AF(GPIOI_PIN4, 0) |           \
                                     PIN_AFIO_AF(GPIOI_PIN5, 0) |           \
                                     PIN_AFIO_AF(GPIOI_PIN6, 0) |           \
                                     PIN_AFIO_AF(GPIOI_PIN7, 0))
#define VAL_GPIOI_AFRH              (PIN_AFIO_AF(GPIOI_PIN8, 0) |           \
                                     PIN_AFIO_AF(GPIOI_PIN9, 0) |           \
                                     PIN_AFIO_AF(GPIOI_PIN10, 0) |          \
                                     PIN_AFIO_AF(GPIOI_PIN11, 0) |          \
                                     PIN_AFIO_AF(GPIOI_PIN12, 0) |          \
                                     PIN_AFIO_AF(GPIOI_PIN13, 0) |          \
                                     PIN_AFIO_AF(GPIOI_PIN14, 0) |          \
                                     PIN_AFIO_AF(GPIOI_PIN15, 0))


#if !defined(_FROM_ASM_)
#ifdef __cplusplus
extern "C" {
#endif
  void boardInit(void);
#ifdef __cplusplus
}
#endif
#endif /* _FROM_ASM_ */

#endif /* _BOARD_H_ */
