openrobots-dev/R2P_GW_module/(commit log)

2012-09-25 Preliminary firmware
    A preliminary firmware was added, based on the STM32F4-DISVOCERY demo.
    It has support (initialization) for:
    _ PAL
    _ MAC RMII
    _ SERIAL
    _ UART
    _ USB FS
    _ SERIAL/USB (CDC)
    Andrea Zoppi
2012-10-14 Schematic reworked
    The schematic was reworked to support a new architecture.
    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
2012-10-17 First PCB version almost finished
    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
    [R2P_GW_module.brd, R2P_GW_module.sch]
2012-10-17 All the PCB elements routed
    The board has yet to be finally checked.
    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
    [R2P_GW_module.brd, R2P_GW_module.sch]
2012-10-18 Minor refinements
    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
    [R2P_GW_module.brd, R2P_GW_module.sch]
2012-10-26 Minor fixes
    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
    [R2P_GW_module.brd]
2012-12-23 Small fixes
    Ethernet CT and CR wired to VDD.
    R12 changed from 100k to 2k2.
    Small changes in traces.
    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
    [R2P_GW_module.brd, R2P_GW_module.csv, R2P_GW_module.sch]
2012-12-23 Small updates
    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
    [R2P_GW_module.brd, R2P_GW_module.sch]
2013-04-08 Updated blinking led demo
2013-04-11 added blinking led main source
2013-06-18 Added LWIP test app
    [R2P_GW_module.sch]
2013-09-19 merged local and remote master branch
    [R2P_GW_module.sch]
